DavidPowell/FreetailHardware/README.md

Hardware for Freetail module

Teensy 3.2 Symbol and Footprint adapted from work of Ricardo Band, under MIT License:
https://github.com/XenGi/teensy.pretty
https://github.com/XenGi/teensy_library
