DavidPowell/FreetailHardware/FreetailHardware.pdf

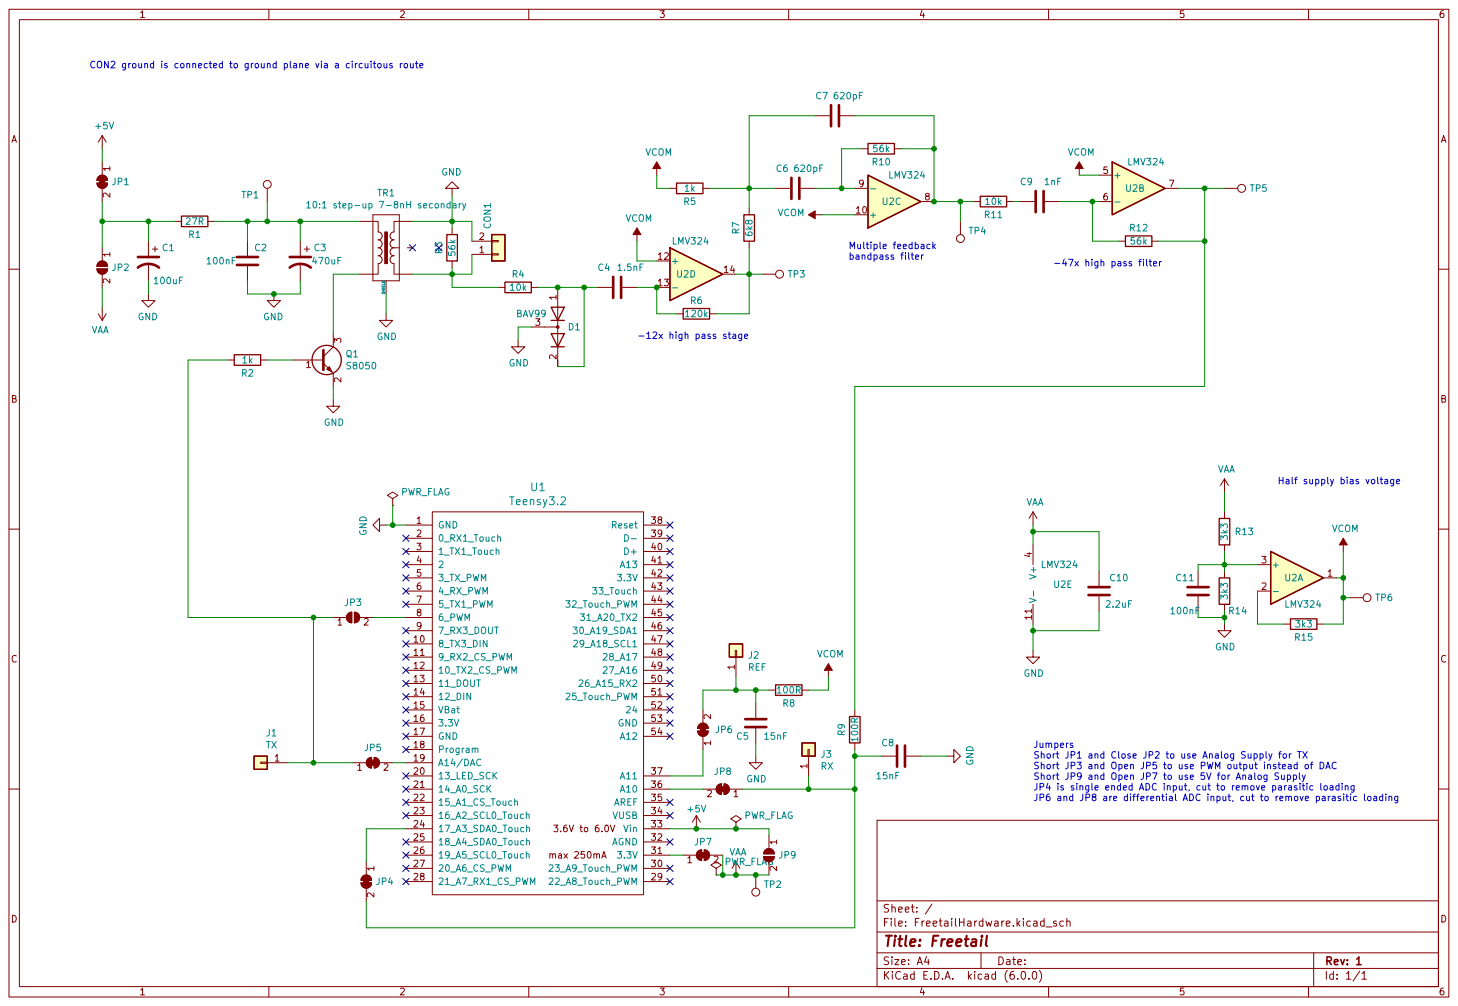
[picture p1: page 1]

CON2 ground is connected to ground plane via a circuitous route

Half supply bias voltage

Jumpers
Short JP1 and Close JP2 to use Analog Supply for TX
Short JP3 and Open JP5 to use PWM output instead of DAC
Short JP9 and Open JP7 to use 5V for Analog Supply
JP4 is single ended ADC input, cut to remove parasitic loading
JP6 and JP8 are differential ADC input, cut to remove parasitic loading
