DavidPowell/FreetailHardware/FreetailHardware.kicad_pcb

## KiCad design FreetailHardware.kicad_pcb (2022-02-04)

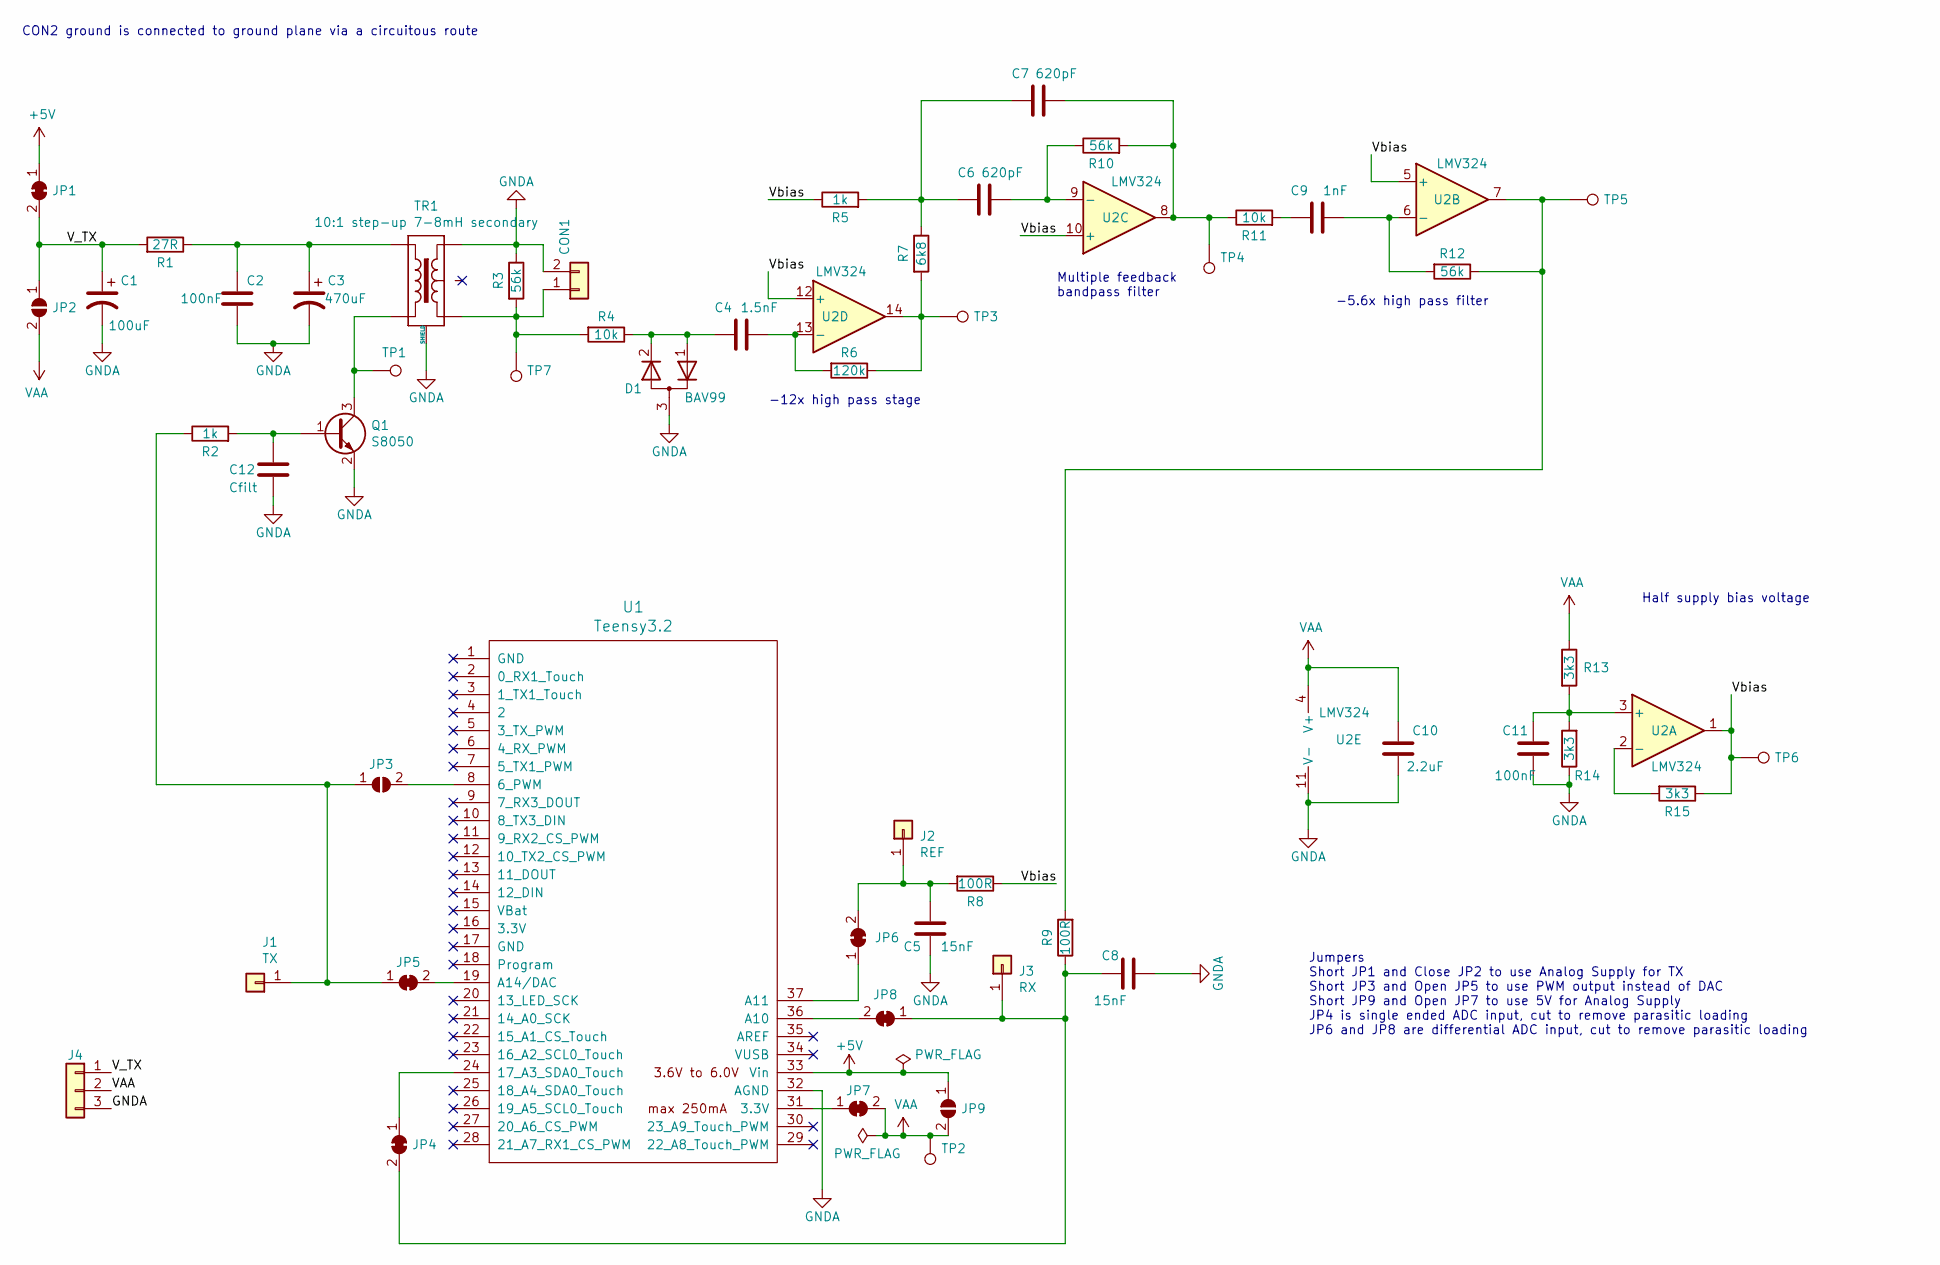
[picture p2: schematic FreetailHardware.kicad_sch, Freetail]

Parts:
C1: 100uF; CP_Radial_D5.0mm_P2.00mm; Digikey Part 732-8702-1-ND
C2, C11: 100nF; C_0603_1608Metric_Pad1.08x0.95mm_HandSolder; Digikey Part 1276-1006-1-ND
C3: 470uF; CP_Radial_D6.3mm_P2.50mm; Digikey Part 732-8708-1-ND
C4: 1.5nF; C_0603_1608Metric_Pad1.08x0.95mm_HandSolder; Digikey Part 1276-6666-1-ND
C5, C8: 15nF; C_0603_1608Metric_Pad1.08x0.95mm_HandSolder; Digikey Part 478-06033C153JAT2ACT-ND
C6, C7: 620pF; C_0603_1608Metric_Pad1.08x0.95mm_HandSolder; Digikey Part 1292-1540-1-ND
C9: 1nF; C_0603_1608Metric_Pad1.08x0.95mm_HandSolder; Digikey Part 478-1187-1-ND
C10: 2.2uF; C_0603_1608Metric_Pad1.08x0.95mm_HandSolder; Digikey Part 1276-1085-1-ND
C12: Cfilt; C_0603_1608Metric_Pad1.08x0.95mm_HandSolder
CON1: Transducer; PinHeader_1x02_P2.54mm_Vertical
D1: BAV99; SOT-323_SC-70_Handsoldering; Digikey Part 1727-6384-1-ND
J1: TX; PinHeader_1x01_P2.54mm_Vertical
J2: REF; PinHeader_1x01_P2.54mm_Vertical
J3: RX; PinHeader_1x01_P2.54mm_Vertical
J4: Conn_01x03; PinHeader_1x03_P2.54mm_Vertical
JP1, JP4, JP5, JP6, JP7, JP8: SolderJumper_2_Bridged; SolderJumper-2_P1.3mm_Bridged_RoundedPad1.0x1.5mm
JP2, JP3, JP9: SolderJumper_2_Open; SolderJumper-2_P1.3mm_Open_RoundedPad1.0x1.5mm
Q1: S8050; SOT-23_Handsoldering; Digikey Part 641-1790-1-ND
R1: 27R; R_0603_1608Metric_Pad0.98x0.95mm_HandSolder; Digikey Part RMCF0603FT27R0CT-ND
R2, R5: 1k; R_0603_1608Metric_Pad0.98x0.95mm_HandSolder; Digikey Part RMCF0603FT1K00CT-ND
R3, R10: 56k; R_0603_1608Metric_Pad0.98x0.95mm_HandSolder; Digikey Part RMCF0603FT56K0CT-ND
R4, R11: 10k; R_0603_1608Metric_Pad0.98x0.95mm_HandSolder; Digikey Part YAG2321CT-ND
R6: 120k; R_0603_1608Metric_Pad0.98x0.95mm_HandSolder; Digikey Part RMCF0603FT120KCT-ND
R7: 6k8; R_0603_1608Metric_Pad0.98x0.95mm_HandSolder; Digikey Part RMCF0603FT6K80CT-ND
R8, R9: 100R; R_0603_1608Metric_Pad0.98x0.95mm_HandSolder; Digikey Part RMCF0603FT100RCT-ND
R12: 56k; R_0603_1608Metric_Pad0.98x0.95mm_HandSolder; Digikey Part RMCF0603FT470KCT-ND
R13, R14, R15: 3k3; R_0603_1608Metric_Pad0.98x0.95mm_HandSolder; Digikey Part 311-3.30KHRCT-ND
TP1, TP2, TP3, TP4, TP5, TP6, TP7: TestPoint; TestPoint_THTPad_D1.5mm_Drill0.7mm
TR1: 10:1 step-up 7-8mH secondary; Ultrasonic transformer
U1: Teensy3.2; Teensy32
U2: LMV324; TSSOP-14_4.4x5mm_P0.65mm; Digikey Part LMV324TSG-13DICT-ND

Connections:
+5V: JP1.1 (A), JP9.1 (A), U1.33 (Vin)
/V_TX: C1.1, J4.1, JP1.2 (B), JP2.1 (A), R1.2
/Vbias: R5.1, R8.1, R15.1, TP6.1, U2.1, U2.5 (+), U2.10 (+), U2.12 (+)
GNDA: C1.2, C2.1, C3.2, C5.1, C8.2, C10.1, C11.1, C12.2, CON1.2, D1.3 (A), J4.3, Q1.2 (E), R3.1, R14.1, TR1.3, TR1.7 (SHIELD), TR1.8, U1.32 (AGND), U2.11 (V-)
unnamed: C2.2, C3.1, R1.1, TR1.4
unnamed: C4.1, R6.2, U2.13 (-)
unnamed: C4.2, D1.1 (K), D1.2 (K), R4.1
unnamed: C5.2, J2.1, JP6.2 (B), R8.2
unnamed: C6.1, R10.1, U2.9 (-)
unnamed: C6.2, C7.2, R5.2, R7.1
unnamed: C7.1, R10.2, R11.1, TP4.1, U2.8
unnamed: C8.1, J3.1, JP4.2 (B), JP8.1 (A), R9.1
unnamed: C9.1, R12.2, U2.6 (-)
unnamed: C9.2, R11.2
unnamed: C11.2, R13.2, R14.2, U2.3 (+)
unnamed: CON1.1, R3.2, R4.2, TP7.1, TR1.1
unnamed: J1.1, JP3.1 (A), JP5.1 (A), R2.1
unnamed: JP3.2 (B), U1.8 (6_PWM)
unnamed: JP4.1 (A), U1.24 (17_A3_SDA0_Touch)
unnamed: JP5.2 (B), U1.19 (A14/DAC)
unnamed: JP6.1 (A), U1.37 (A11)
unnamed: JP7.1 (A), U1.31 (3.3V)
unnamed: JP8.2 (B), U1.36 (A10)
unnamed: C12.1, Q1.1 (B), R2.2
unnamed: Q1.3 (C), TP1.1, TR1.6
unnamed: R6.1, R7.2, TP3.1, U2.14
unnamed: R9.2, R12.1, TP5.1, U2.7
unnamed: R15.2, U2.2 (-)
VAA: C10.2, J4.2, JP2.2 (B), JP7.2 (B), JP9.2 (B), R13.1, TP2.1, U2.4 (V+)

Notes on the sheet:
-12x high pass stage
Jumpers Short JP1 and Close JP2 to use Analog Supply for TX Short JP3 and Open JP5 to use PWM output instead of DAC Short JP9 and Open JP7 to use 5V for Analog Supply JP4 is single ended ADC input, cut to remove parasitic loading JP6 and JP8 are differential ADC input, cut to remove parasitic loadi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
Multiple feedback bandpass filter
-5.6x high pass filter
CON2 ground is connected to ground plane via a circuitous route
Half supply bias voltage

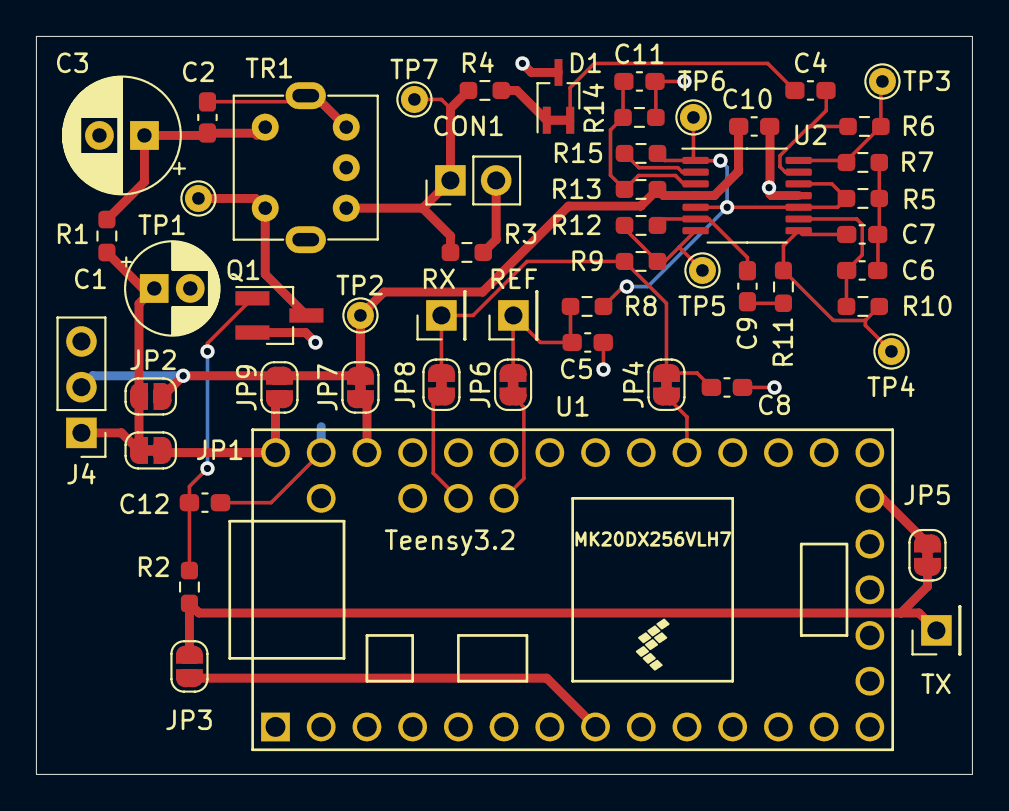
[picture p3: board FreetailHardware.kicad_pcb from above]

Board: 2 copper layers, 52.0 x 41.0 mm, 54 parts (1 on the bottom side), 29 nets.

Other parts of the board:
Logo: Logo; freetail
