DavidPowell/FreetailHardware/(commit log)

2022-01-10 Version 1.0, as fabricated
    [FreetailHardware.kicad_pcb, FreetailHardware.sch]
2022-01-10 Updated to KiCad v6
    [FreetailHardware.kicad_pcb, FreetailHardware.kicad_sch, FreetailHardware.sch]
2022-01-10 Update R12 to 56k to reduce final stage gain
    [FreetailHardware.kicad_sch]
2022-01-13 v1.1 Hardware sent for fabrication
    [FreetailHardware.kicad_pcb, FreetailHardware.kicad_sch]
2022-02-04 Version 1.2 sent for fabrication Fix unconnected Vbias Mark soldered pads for Teensy Add capacitor for TX filter
    [FreetailHardware.kicad_pcb, FreetailHardware.kicad_sch]
2022-02-10 Added BOM for 1.3 design
